wsilverio/te161-conversor-boost/relatorio-final/relatorio-final-boost.pdf

UNIVERSIDADE FEDERAL DO PARANÁ

BRUNA RIBEIRO RESENDE

WENDEURICK SILVERIO

PROJETO DE CONVERSORES CC-CC

CONVERSOR ELEVADOR DE TENSAO (BOOST) ˜

CURITIBA

2018

BRUNA RIBEIRO RESENDE

WENDEURICK SILVERIO

PROJETO DE CONVERSORES CC-CC

CONVERSOR ELEVADOR DE TENSAO (BOOST) ˜

Relatório apresentado à disciplina de Conversores CC-CC e Inversores do curso de Engenharia Elétrica do Departamento de Engenharia Elétrica, Setor de Tecnologia da Universidade Federal do Paraná.

Orientador: Prof. | Dr. | João Américo
Vilela Júnior.

CURITIBA

2018

Conteúdo

1 Introdução | 2
2 Objetivos | 2
3 Especificação de Componentes do Conversor | 2
4 Projeto do Indutor | 10
5 Projeto do Compensador | 12
6 Placa de Circuito Impresso | 20
7 Resultados | 24
8 Conclusões | 32

### 1 Introdução

Por fim, são apresentadas e discutidas as conclusões e observações de cada etapa

do desenvolvimento do projeto proposto.

### 2 Objetivos

### 2.1 Objetivo Geral

A finalidade do projeto apresentado se resume na implementação de uma das

topologias de conversor CC-CC, neste caso, o conversor elevador de tensão (Boost). Esta implementação seguirá as seguintes especificações:

Tabela 1: Especificações do Conversor CC-CC Boost

Parâmetros de Implementação
Tensão de Entrada | 9 − 18Vcc
Tensão de Saída | 24Vcc
Frequência de Comutação | 250kHz
Potência do Conversor | 30W

### 2.2 Objetivos Específicos

- Especificação dos componentes do conversor;
- Projeto do indutor;
- Definição e simulação do compensador;
- Layout e confecção da placa de circuito impresso;
- Testes em bancada para verificação do funcionamento do conversor Boost

de acordo com as especificações do projeto.

### 3 Especificação de Componentes do Conversor

Nesta seção é realizado o levantamento dos dados necessários para a determinação dos componentes de um conversor CC-CC elevador (Boost) (Figura

1), cuja a especificação é dada a seguir: Vin = 9 − 18V , Vout = 24V , P = 30W

e F req = 250kHz.

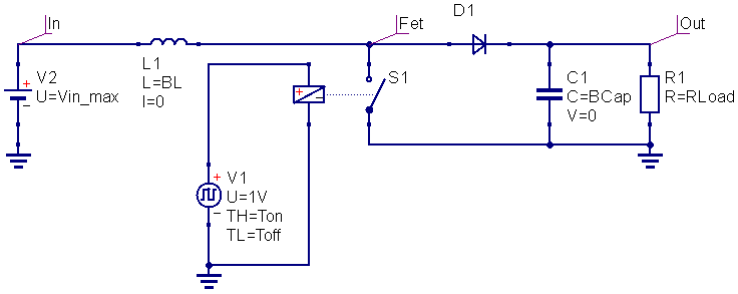
[picture p38: figure]

Figura 1: Esquemático do conversor Boost.

A partir desses parâmetros, tem-se os valores da carga e sua corrente média:

Rout =

V

2
out
P

=

24²

30

= 19, 2Ω

(1)

Ioutmed =

P

Vout

=

30
24

= 1, 250A

(2)

Com isso, através do software Qucs, simulou-se o circuito da Figura 1, obtendo-

se os parâmetros a seguir.

1. Capacitor
(a) Capacitância

A escolha da capacitância leva em conta a variação da tensão de saída

(4Vout ) e a razão cíclica (D) da chave.

O ciclo de trabalho foi calculado para o pior caso, ou seja, quando D assume seu valor máximo (quando a tensão de entrada assume o valor

mínimo):

D = 1 −

Vin

Vout

= 1 −

9
= 62.5%

(3)

Para este projeto, adotou-se a variação de tensão igual a 4%. A Equação

4 apresenta o cálculo do valor mínimo da capacitância.

Cap ≥

Dmax · Iout

4Vout · freq

=

62, 5% · 1, 250
4% · 250k

= 78, 125µF

(4)

(b) Tensão máxima

Através da simulação, obteve-se a tensão máxima que o capacitor deve

suportar (37,5V, quando Vin = 18V ).

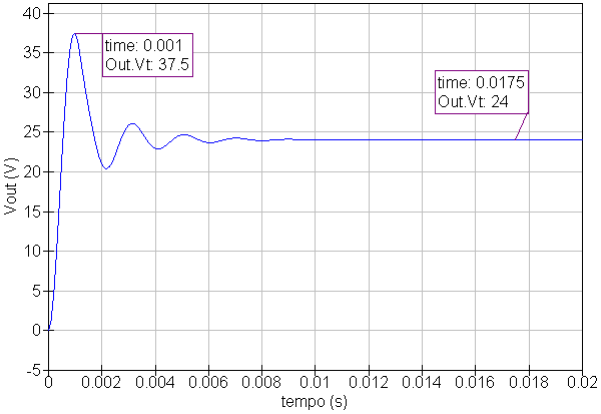
[picture p39: figure]

Figura 2: Pico de tensão sobre a carga/capacitor.

(c) ESR máxima

Neste projeto, adotou-se 4% como sendo o valor da máxima variação da

corrente de saída (4Iout ). A Equação 5 apresenta o cálculo da resistência

séria máxima do capacitor.

ESR ≤

4Vout

4Iout

=

4%
4% = 1Ω

(5)

2. Indutor
(a) Indutância

O cálculo para o valor mínimo da indutância (Equação 7) foi feito sobre

o ponto onde o produto (D · Vin) atinge seu valor máximo:

max {D · Vin} = max
(Vout − Vin)

Vout

- Vin

= max
(24 − Vin)
24
- Vin
= 6 → Vin = 12 → D = 50%

(6)

L ≥

D · Vin
4IL
- freq

=

6
4% · 250k

= 600µH

(7)

(b) Corrente média

Através da simulação, obteve-se a corrente média que o indutor deve

suportar (4,51A, quando Vin = 9V ).


Figura 3: Corrente média sobre o indutor.

(c) Corrente máxima

Através da simulação, obteve-se a corrente máxima que o indutor deve

suportar (8,22A, quando Vin = 18V ).


Figura 4: Corrente máxima sobre o indutor.

3. Diodo
(a) Corrente média e corrente máxima

A corrente no diodo é aproximadamente igual à corrente sobre a carga

(desconsiderando os picos de carga sobre o capacitor).


Figura 5: Corrente sobre o diodo/carga.

Através da simulação, obteve-se a corrente média e máxima que o diodo deve suportar (1,25A e 1,95, respectivamente, quando Vin = 18V ).

(b) Tensão reversa máxima

Através da simulação, obteve-se a máxima tensão reversa que o diodo

deve suportar (35,6V, quando Vin = 18V ).


Figura 6: Tensão reversa sobre o diodo.

4. Mosfet
(a) Corrente média

Através da simulação, obteve-se a corrente média que a chave deve

suportar (4,54A, quando Vin = 9V ).


Figura 7: Corrente média sobre a chave.

(b) Corrente máxima

Através da simulação, obteve-se a corrente máxima que a chave deve

suportar (8,22A, quando Vin = 18V ).


Figura 8: Corrente máxima sobre a chave.

(c) Tensão Dreno-Fonte

Através da simulação, obteve-se a tensão máxima que a chave deve

suportar (8,22V, quando Vin = 18V ).


Figura 9: Tensão máxima sobre a chave.

Escolha dos componentes

A partir dos dados obtidos através dos cálculos, da simulação e da disponibili-

dade, foram definidos os seguintes componentes:

1. Capacitor
- Fabricante: Nichicon
- Part number: UVR1H470MED1TD
- Capacitância: 2x47µF ±20% (2 em paralelo)
- Tensão máxima de operação: 50V
- ESR: não especificada pelo fabricante. Medida: 490mΩ.
2. Diodo
- Fabricante: Vishay General Semiconductor
- Part number: SB260
- Queda de tensão: 680mV @ 2A
- Corrente média: 2,0A
- Pico máximo de corrente: 60A @ 8,3ms
- Máxima tensão reversa: 60V
3. Mosfet
- Fabricante: Infineon Technologies
- Part number: IRFZ44EPBF
- Corrente média: 48A
- Pico máximo de corrente: 192A
- Tensão máxima entre dreno e fonte: 60V
- Resistência Dreno-Fonte modo triodo: 23mΩ @VGS = 10V, ID = 29A
- Tensão de limiar no gate: 2V - 4V

### 4 Projeto do Indutor

Para o cálculo do número de espiras do indutor em questão, foi utilizada a me-

todologia a partir do comprimento de entreferro. Assim, o carretel foi projetado

de forma que o comprimento do entreferro fosse igual a 1,6mm, ou seja:

lg
2

= 0, 8mm

N =

s
lg · L
µ0 · Ae

=

s
1, 6 · 10⁻³
- 600 · 10⁻⁶
4 · π · 10⁻⁷
- 1, 7 · 10⁻⁴

= 67, 09 espiras

Onde:

- L - indutância [H]
- µ0 - permeabilidade magnética do vácuo [H/m]
- Ae - área do núcleo [m²
]

Assim, utilizou-se 68 espiras para a construção do indutor. No entanto, é ne-

cessário verificar se a densidade de fluxo Bmax não ultrapassa o valor de 0,3T,

provocando a saturação do núcleo. Como pode ser observado na Equação 8,

não haverá saturação.

Bmax =

L · Ipico
N · Ae

=

600 · 10⁻⁶
- 1, 275
68 · 1, 7 · 10⁻⁴
= 0, 066T | (8)

Foi então analisada a área disponível para o número de espiras calculado, pela

equação abaixo, considerando a densidade de corrente máxima Jmax igual a 450A/cm²
e a corrente eficaz Ief igual a 1,25 A.

At =

Ief

Jmax

= 0, 0027cm² = 0, 27mm²
(9)

No entanto, a corrente utilizada foi equivocada, uma vez que se considerou a

corrente de saída média e não a corrente máxima que efetivamente passa pelo

indutor em regime permanente. O erro foi identificado após a implementação do

conversor e durante os ensaios, onde o indutor aqueceu. Refazendo os cálculos

para verificar a dimensão do erro, utilizou-se a corrente máxima, na condição

da tensão de entrada mínima, igual a 3,33 A:

At =

Imax

Jmax

= 0, 0074cm² = 0, 74mm²
(10)

Dessa forma, seria necessária a utilização de um condutor AW G18, cuja seção é de 0, 82mm²

Porém, como se está operando em frequência elevada para eletrônica de potência,

deve-se considerar o efeito pelicular, utilizando a frequência do projeto igual a

250kHz.

4 =

7, 5
√
f

= 0, 015cm = 0, 15mm

Como o raio do condutor deve ser menor que 4, o condutor mais indicado

seria o AW G29, cujo raio é de 0,14295mm. No entanto, havia a disponibilidade

do condutor AW G30 e assim, seria necessária a utilização de um número de

condutores em paralelo obtido pela equação:

ncp =

AW G18
AW G30

= 16, 07 ≈ 17 condutores em paralelo

Assim, realizando os mesmos cálculos, porém com o valor da corrente média de

saída, foi obtido um número de 3 condutores em paralelo utilizando o AW G30,

valor muito distante do necessário. Assim, o indutor foi construído com o

condutor AW G30 e 3 condutores em paralelo.

Após a construção do indutor, a medição de sua indutância indicou aproxima-

damente 643, 7µH. Além disso, a ESR medida foi igual a 480mΩ. (obs.: a

Seção 8 aborda novamente o projeto do indutor).

### 5 Projeto do Compensador

### 5.1 Circuito de Controle

O compensador escolhido foi o do Tipo 3, cujo circuito e função transferência

são apresentados nas Figuras 10 e 11, respectivamente.


Figura 10: Circuito do Compensador Tipo 3.

Figura 11: Função transferência do Compensador Tipo 3.

A equação 11 apresenta a função transferência do conversor Boost.

GBoost =

Vin
L · C · (1 − D)

2

·

−

RSE·L·C·s

2
R0

+

RSE · C −

L
R0

- s + 1
s

2 +

1
R0·C +

RSE
L
- s +

1
L·C
| (11)

Onde

- Vin: tensão de entrada
- L: valor do Indutor Boost
- C: valor do Capacitor Boost
- RSE: ESR do capacitor
- R0: carga do circuito
- D: razão cíclica
- s: variável no plano complexo (frequência complexa)

O projeto do compensador foi dado no ponto V in = 13, 5V . Assumindo esse

valor na Equação 3, tem-se o valor da razão cíclica igual a D = 0, 4375.

A fim de se obter valores mais próximos para o caso real, os componentes físicos

foram medidos e o compensador foi projetado levando em conta esses valores.

- L = 643, 7µH
- C = 2 · 47µ = 94µF (capacitores em paralelo)
- RSE = 0, 49Ω/2 = 0, 245Ω (capacitores em paralelo)
- R0 = 19, 2Ω

Com isso, obteve-se os diagramas de Bode em malha aberta, apresentados na

Figura 12. Logo após, escolheu-se 2,08kHz para ser a frequência de corte em malha fechada, ponto onde a fase é de 166o

(-194o
) e magnitude é de 14dB

(5,01V/V).


Figura 12: Diagramas de Bode da função transferência do conversor Boost.

Optou-se pela margem de fase igual a 60o . Com isso, obteve-se o avanço de

fase, conforme a Equação 12.

φavanço = −90◦ + MFdesejada − ⁶ GBoost |fc

= −90◦ + 60◦ − (−194◦

) = 164◦

(12)

O ganho do compensador deve ser tal que leve a um ganho unitário em malha fechada, na frequência de corte (Equação 13).

| GF TMA (s) |fc=| GC (s) |fc

- | GPWM (s) |fc
- | GBoost (s) |fc

·k = 1 (13)

Substituindo os seguintes valores na Equação 13, obteve-se o Ganho do Compensador | Gc (s) |fc= 1, 7957V/V .

- Ganho da planta do conversor: | GBoost (s) |fc= 5, 01
- Ganho da modulação PWM: | GPWM (s) |fc= 1/Vtriang = 1/1, 8 = 0, 5556
- Ganho do divisor resistivo de feedback: k = 5V/24V = 0, 2

O fator kpz é dado pela Equação 14.

kpz =

tan
φavanço
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
= 204, 5091

(14)

Tomando o resistor R1 = 510kΩ, calculou-se os demais componentes do com-

pensador.

C2 =

1
2 · π · fc
- R1· | Gc (s) |

=

1
2 · π · 2, 08kHz · 510kΩ · 1, 7957

= 83, 550pF

(15)

C1 = C2 · (kpz − 1)

= 83, 550pF · (204, 5091 − 1) = 17nF

(16)

R2 =

p
kpz
2 · π · fc · C1

=

√
204, 5091
2 · π · 2, 08kΩ · 17nF

= 64, 355kΩ

(17)

R3 =

R1
kpz − 1

=

510kΩ
204, 5091 − 1

= 2, 51kΩ

(18)

C3 =

1
2 · π · fc
- R3 ·

p
kpz

=

1
2 · π · 2, 08kHz · 2, 51kΩ ·

√
204, 5091

= 2, 14nF

(19)

Após os cálculos, foi feita uma aproximação com valores comerciais e/ou dis-

poníveis, através de arranjos série/paralelo, obtendo aos seguintes valores:

Tabela 2: aproximação com valores comerciais/disponíveis

R1 (kΩ) | 510
R2 (kΩ) | 56
R3 (kΩ) | 2,2
C1 (nF) | 17,2
C2 (pF) | 94
C3 (nF) | 2,2

Substituindo as devidas funções transferências no sistema da Figura 13, obteve-

se os diagramas de Bode da Figura 14.

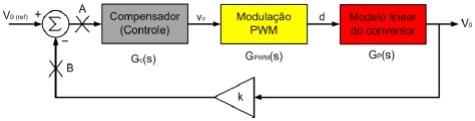
[picture p40: figure]

Figura 13: Sistema de controle do conversor Boost.

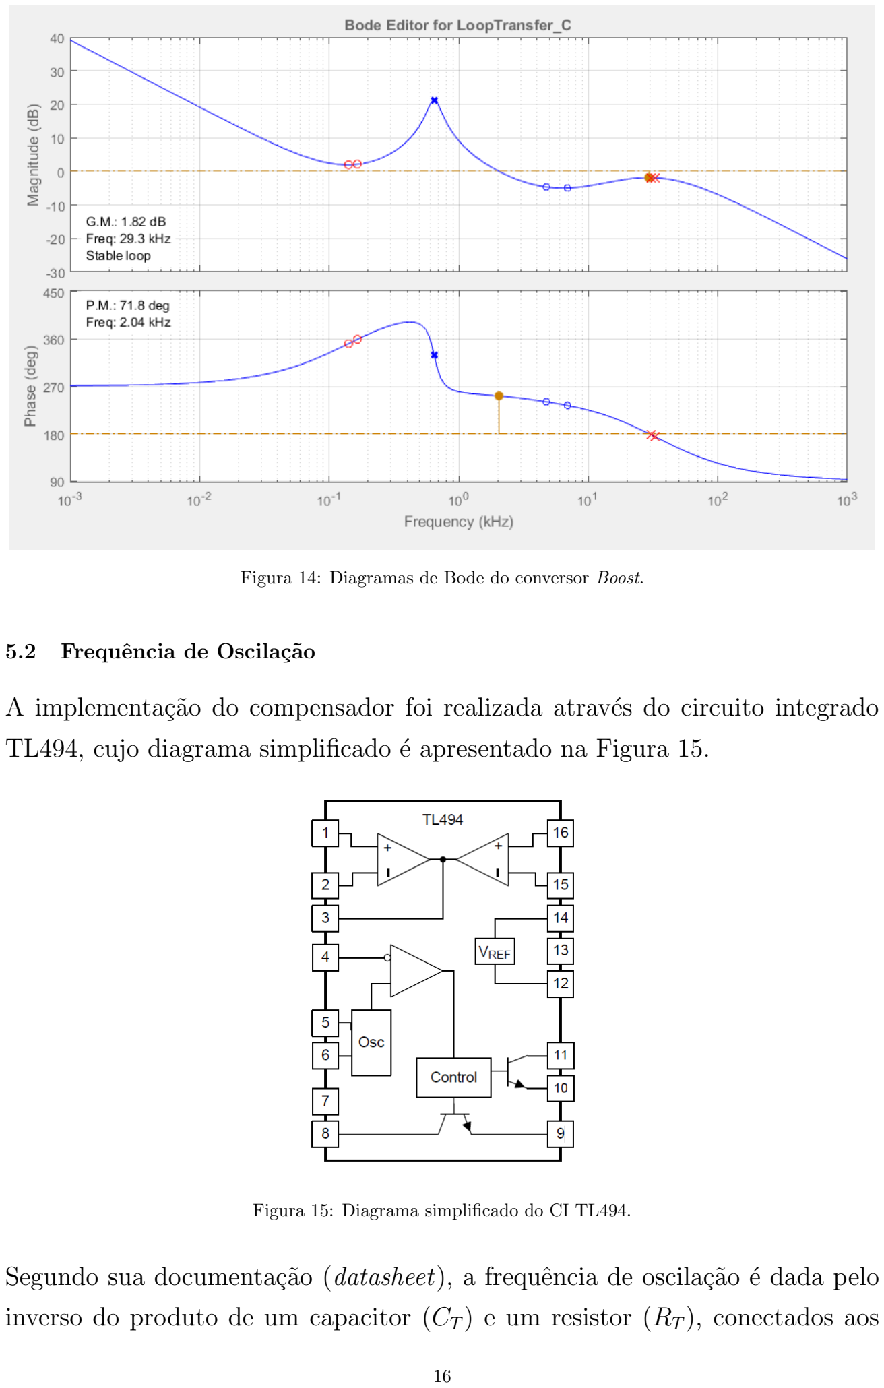
[picture p41: page 18]

Figura 14: Diagramas de Bode do conversor Boost.

### 5.2 Frequência de Oscilação

A implementação do compensador foi realizada através do circuito integrado

TL494, cujo diagrama simplificado é apresentado na Figura 15.

Figura 15: Diagrama simplificado do CI TL494.

Segundo sua documentação (datasheet), a frequência de oscilação é dada pelo

inverso do produto de um capacitor (CT ) e um resistor (RT ), conectados aos pinos 5 e 6, respectivamente. O cálculo para fOSC ≈ 250kHz é apresentado na

Equação 20.

fOSC =

1

CT · RT

=

1
1, 8nF · 2, 2kΩ

= 253kHz

(20)

### 5.3 Tensão de feedback

A entrada não-inversora do comparador (pino 1) recebe a tensão de feedback do

conversor Boost, devendo ser ajustada à faixa 0V - 5V. Para isso, implementou-

se um divisor resistivo, apresentado na Equação 21.

Vfeedbackmax =

24V · 1kΩ
1kΩ + 3, 8kΩ
= 5V | (21)

### 5.4 Soft-start e tempo-morto

As técnicas de soft-start e tempo-morto são necessárias para mitigar o estresse

sobre o Mosfet durante a inicialização do sistema, fazendo com que o capacitor

Boost se carregue lentamente. A Figura 16 apresenta a limitação do ciclo de

trabalho em função da tensão aplicada no pino 4 do circuito integrado.

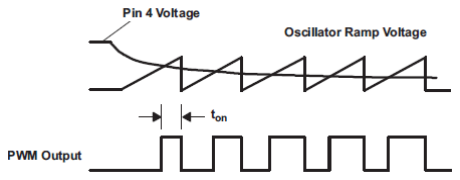
[picture p42: figure]

Figura 16: Controle do ciclo de trabalho.

A entrada do comparador do tempo-morto (pino 4) trabalha com tensões entre

0V e 3,3V, fazendo com que o Mosfet seja cortado, proporcionalmente, de 3%

a 100%, ou seja, a razão cíclica varia entre 0,97 e 0.

A Equação 22 apresenta o cálculo para a máxima tensão no pino 4 em função

do máximo valor da razão cíclica (escolhido D = 85%).

V4max =

3, 3V · (0, 97 − 0, 85)
0, 97
= 0, 408V | (22)

Como pode ser notado na Figura 17, a tensão interna de referência é de 5V,

sendo necessário um divisor resistivo para limitar o pino 4 em 0,408V. Assu-

mindo o resistor shunt igual a 10kΩ, tem-se o seguinte valor do resistor RTss (Equação 23).


Figura 17: Circuito de soft-start.

RTss = Rshunt ·

Vref

V4max

− 1

= 10kΩ ·

5V
0, 408V

− 1

≈ 110kΩ

(23)

Para o tempo de soft-start, definiu-se o equivalente para 93 ciclos de clock,

assim, o valor da capacitância é dada pela Equação 24.

Css =

1

fOSC

·

Nciclos

RTss

=

1
250kHz ·

93
110kΩ

≈ 3, 3nF

(24)

A Figura 18 apresenta o circuito de controle/compensação completo.


Figura 18: Circuito de controle/compensação.

### 6 Placa de Circuito Impresso

A placa de circuito impresso foi projetada com base em boas práticas de leiaute

e alguns cuidados foram tomados em relação à disposição dos circuitos.

O circuito de potência (Figura 19) foi projetado com trilhas largas e buscou-

se fazê-lo com o menor loop possível. Ademais, para diminuir os efeitos da

ESR, o capacitor Boost de 78, 125µF foi substituído por 2 capacitores (CB1

e CB2) de 47µF em paralelo, totalizando ≈ 100µF e metade da ESR inicial

(490mΩ/2 = 245mΩ).

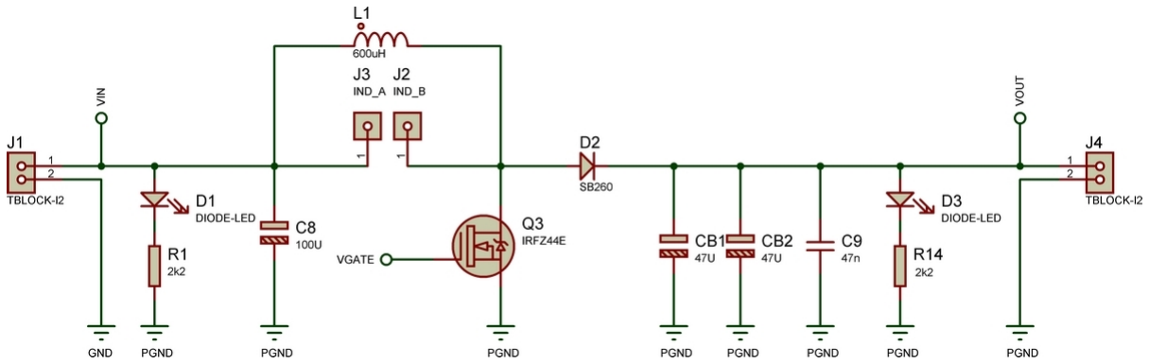
[picture p43: figure]

Figura 19: Esquemático do circuito de potência.

Para evitar que ruídos provenientes dos circuitos de potência (Figura 19) e

de chaveamento (Figura 20) interferissem no circuito de controle (Figura 18),

separou-se os terras através de componentes virtuais neckties, como apresentado

na Figura 21. Dessa forma, cada circuito é tratado de forma individual, tendo a ligação das referências próxima ao conector de entrada (Figura 22).


Figura 20: Esquemático do circuito de chaveamento.


Figura 21: Separação dos terras de alta (PGND) e baixa (AGND) potência.

Além disso, o circuito de controle foi confinado em um pequeno plano de terra

individual, como apresentado na Figura 22.


Figura 22: Destaque do plano confinado e neckties na entrada do circuito separando os terras.

Com o circuito de controle estando afastado do conector de entrada, foram

colocados 2 capacitores de desacoplamento próximos ao CI TL494.

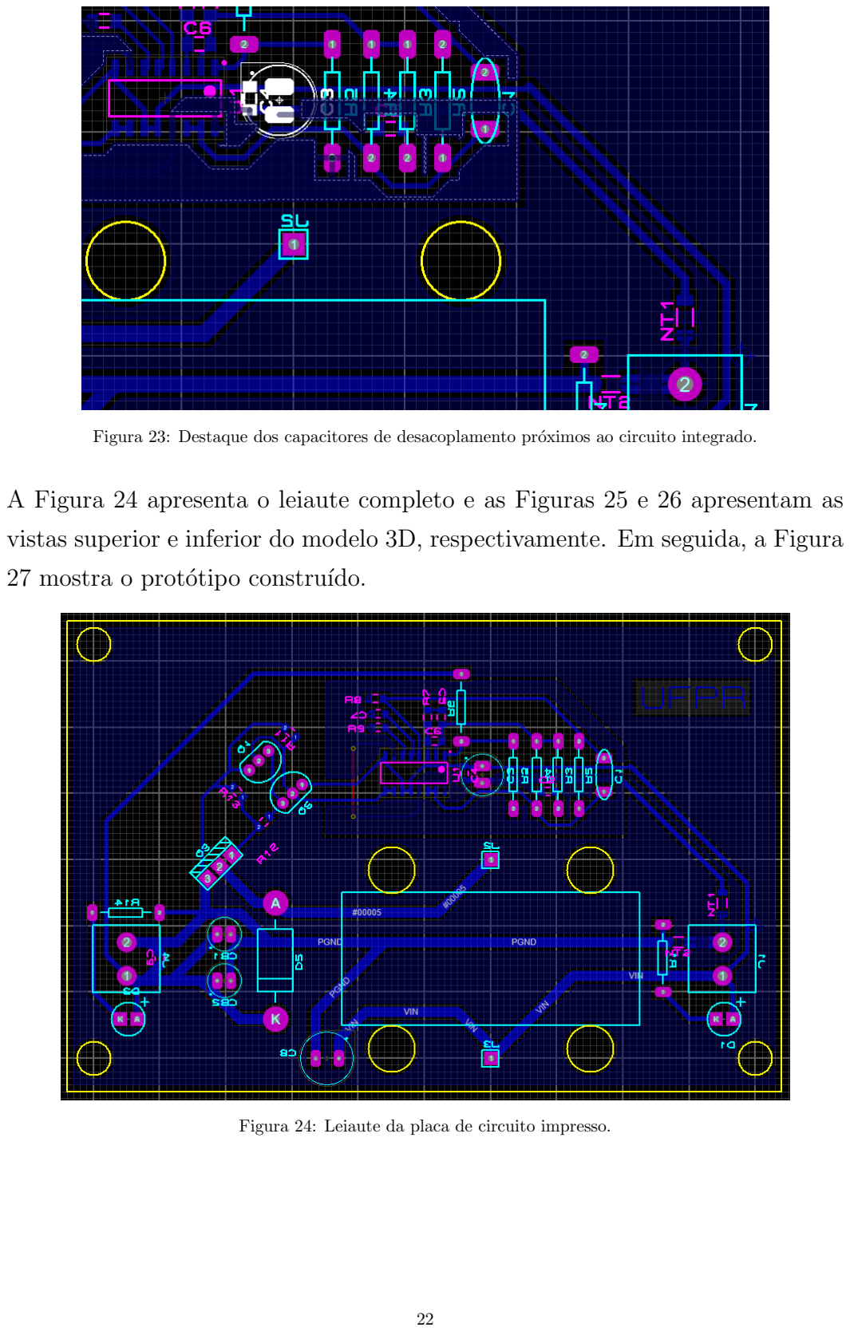
[picture p44: page 24]

Figura 23: Destaque dos capacitores de desacoplamento próximos ao circuito integrado.

A Figura 24 apresenta o leiaute completo e as Figuras 25 e 26 apresentam as

vistas superior e inferior do modelo 3D, respectivamente. Em seguida, a Figura

27 mostra o protótipo construído.

Figura 24: Leiaute da placa de circuito impresso.

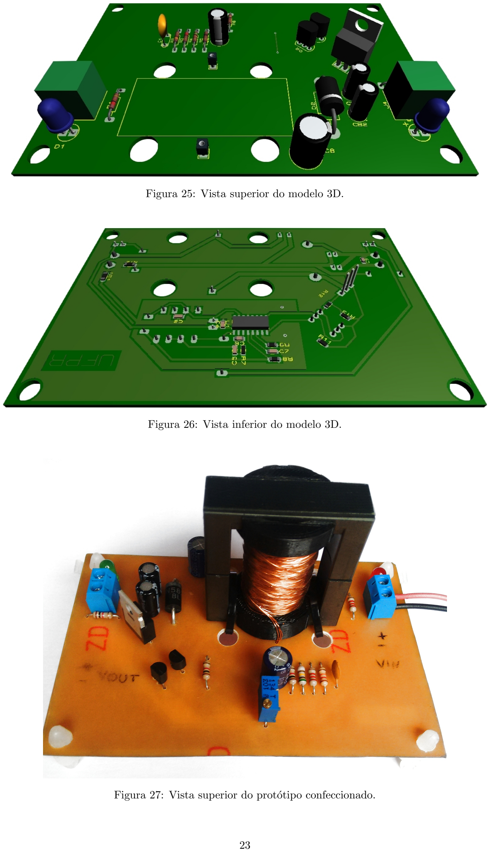
[picture p45: page 25]

Figura 25: Vista superior do modelo 3D.

Figura 26: Vista inferior do modelo 3D.

Figura 27: Vista superior do protótipo confeccionado.

### 7 Resultados

Os parâmetros analisados foram obtidos em 3 pontos bem definidos sobre a

faixa de operação: 9V, 13,5V e 18V.

### 7.1 Ondulação da tensão de saída

As Figuras 28, 29 e 30 apresentam o ripple (ondulação) da tensão de saída para

os 3 casos citados, com carga de 30W.


Figura 28: Ripple da tensão de saída @Vin=18V.

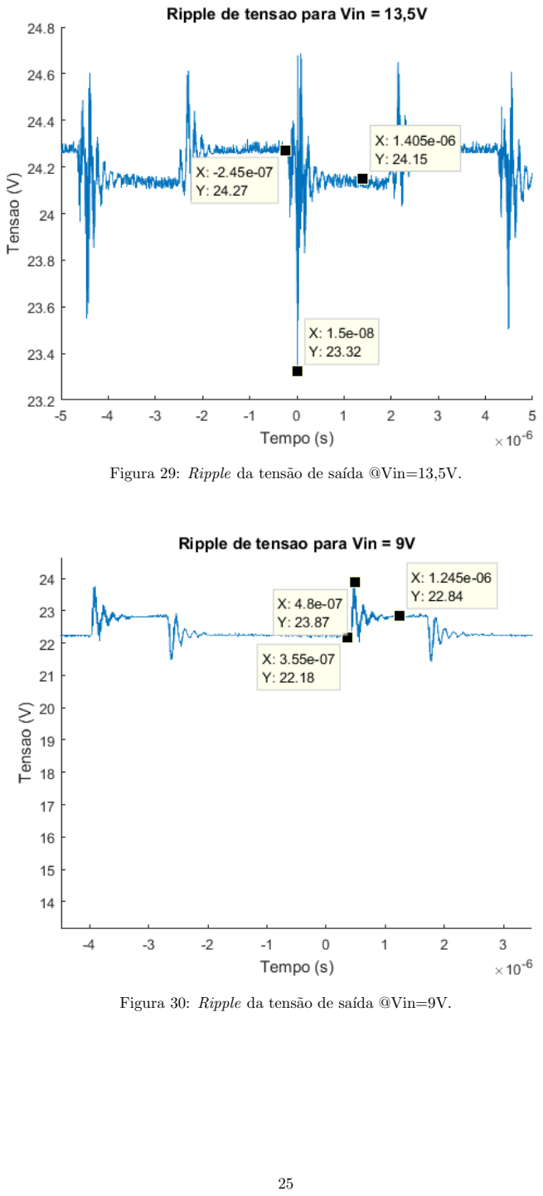
[picture p46: page 27]

Figura 29: Ripple da tensão de saída @Vin=13,5V.

Figura 30: Ripple da tensão de saída @Vin=9V.

### 7.2 Transitório para o aumento da carga

Para esta análise, alterou-se a carga de 15W (2 · RCarga = 38, 4Ω) para 30W

(RCarga = 19, 2Ω). As Figuras 31, 32 e 33 apresentam a oscilação da tensão de

saída em função da alteração brusca (degrau) da carga.


Figura 31: Oscilação da tensão de saída devido a alteração brusca da carga @Vin=18V.

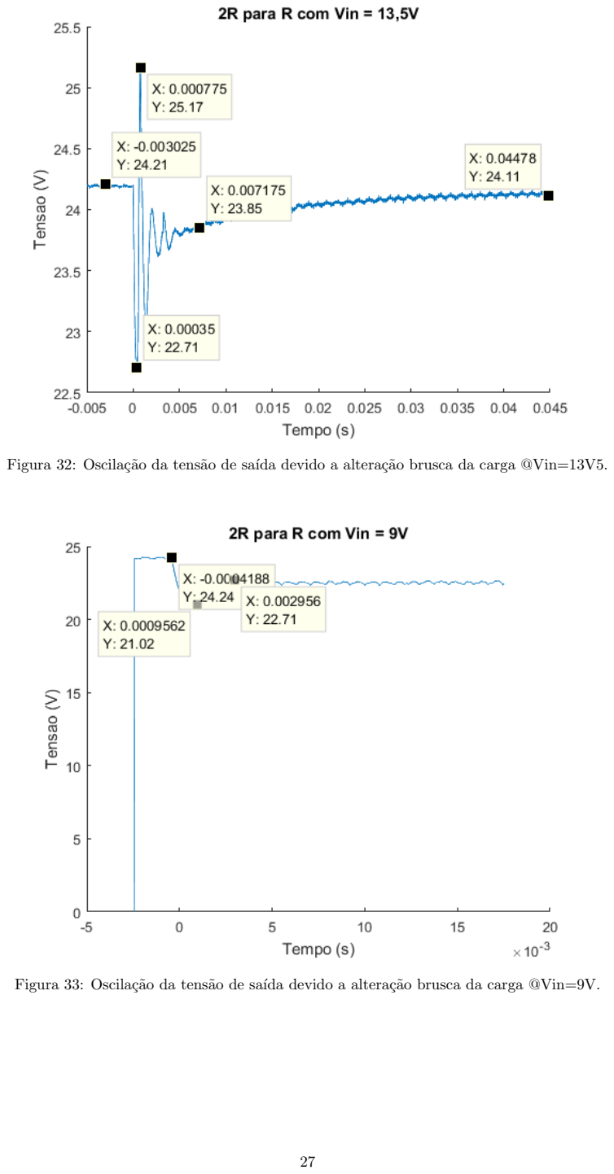
[picture p47: page 29]

Figura 32: Oscilação da tensão de saída devido a alteração brusca da carga @Vin=13V5.

Figura 33: Oscilação da tensão de saída devido a alteração brusca da carga @Vin=9V.

### 7.3 Transitório para a diminuição da carga

Similar ao caso anterior, alterou-se a carga de 30W (RCarga = 19, 2Ω) para 15W

(2 · RCarga = 38, 4Ω). As Figuras 34, 35 e 36 apresentam a oscilação da tensão

de saída em função da alteração brusca (degrau) da carga.


Figura 34: Oscilação da tensão de saída devido a alteração brusca da carga @Vin=18V.

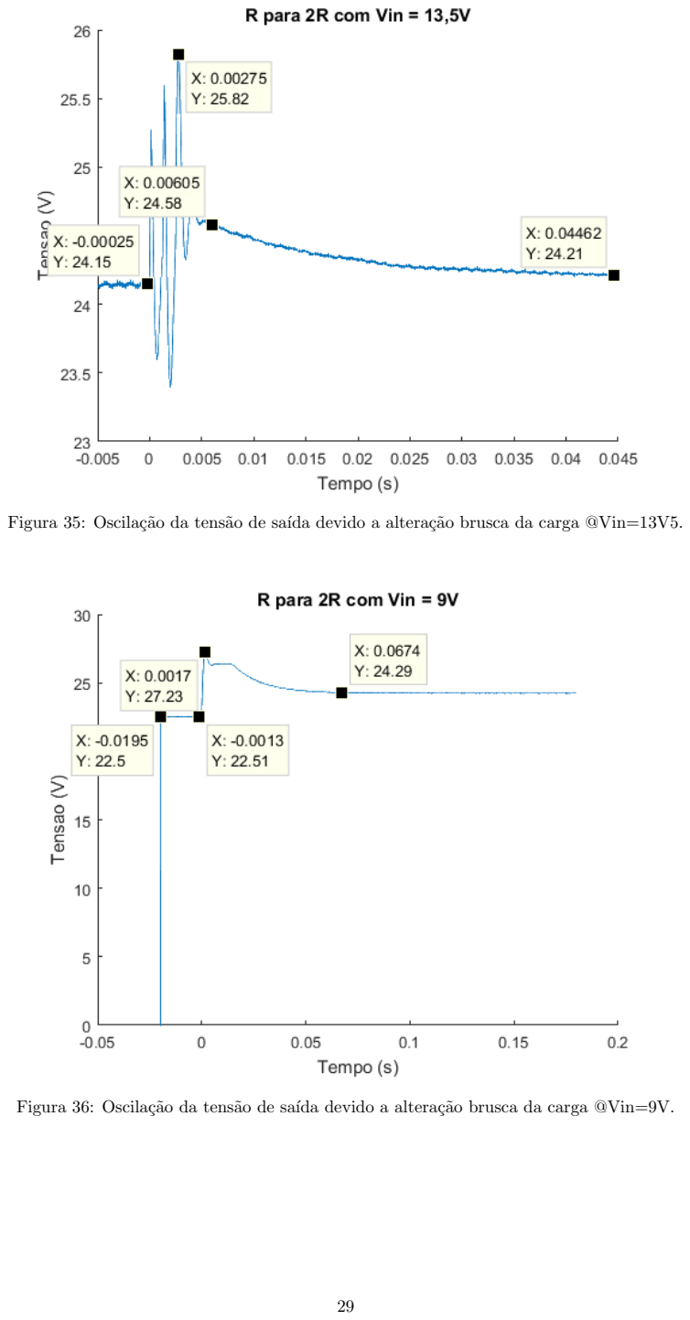
[picture p48: page 31]

Figura 35: Oscilação da tensão de saída devido a alteração brusca da carga @Vin=13V5.

Figura 36: Oscilação da tensão de saída devido a alteração brusca da carga @Vin=9V.

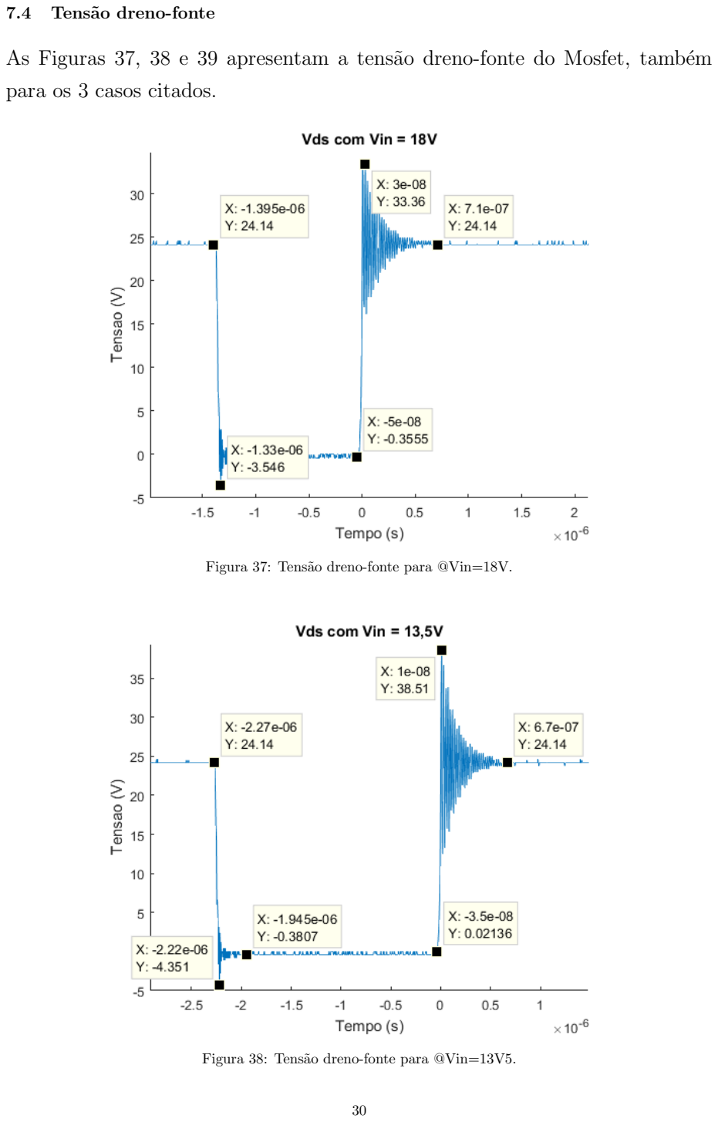
[picture p49: page 32]

### 7.4 Tensão dreno-fonte

As Figuras 37, 38 e 39 apresentam a tensão dreno-fonte do Mosfet, também

para os 3 casos citados.

Figura 37: Tensão dreno-fonte para @Vin=18V.

Figura 38: Tensão dreno-fonte para @Vin=13V5.


Figura 39: Tensão dreno-fonte para @Vin=9V.

### 8 Conclusões

Como se pôde notar na Seção 7, o conversor Boost não atendeu todas as especi-

ficações de projeto. Um indicativo de que havia algo errado foi o fato do indu-

tor estar aquecendo consideravelmente. Ao percebê-lo, reviram-se os cálculos e

notou-se que as correntes eficaz e de pico levadas em conta nas Equações 8 e

10 estão mal levantadas. O correto seria ter considerado os valores de pico da simulação (Seções 2b e 2c). Com o indutor aquecendo, o material do carretel,

produzido em impressora 3D, começou a amolecer. Isso causou a diminuição do entreferro (devido ao peso do núcleo estar sobre o carretel), levando à sa-

turação. Com o núcleo saturado, o indutor não conseguia fornecer a corrente

necessária para suprir a demanda. Com isso, percebe-se que, nos casos em que há maior demanda de corrente (por exemplo, Figura 30), a tensão de saída fica

muito abaixo dos 24V esperados.

Observou-se também que a simulação apresentou valores não condizentes com o

caso real. Como pode-se notar na Seção 7.4, os valores das tensões entre dreno

e fonte foram maiores que os apresentados na Seção 4c. Por sorte, os valores

reais estavam dentro do limite suportado pelo Mosfet.
