wsilverio/te161-conversor-boost/relatorio-final/ESR.png

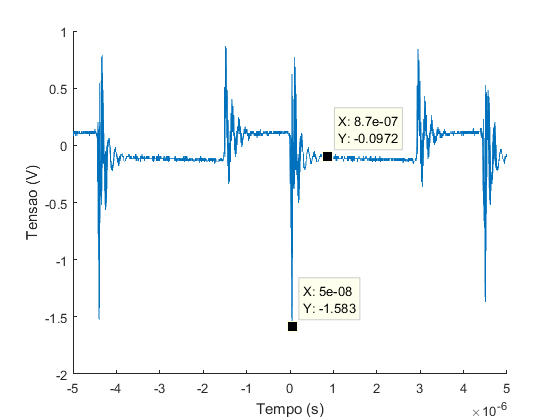
relatorio-final/ESR.png
