wsilverio/te161-conversor-boost/relatorio-final/icarga_vinmin.png

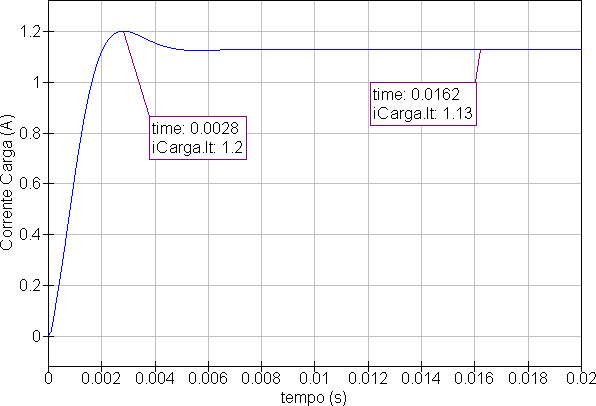
relatorio-final/icarga_vinmin.png
