wsilverio/te161-conversor-boost/relatorio-final/top.png

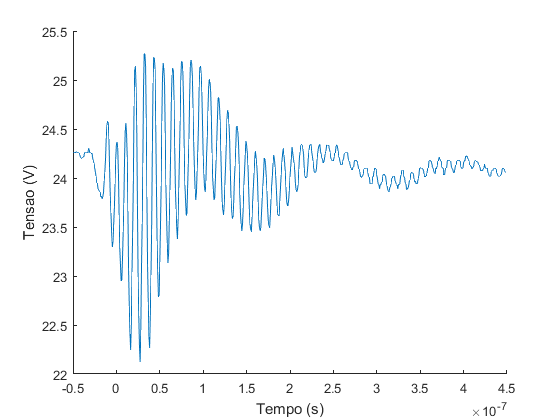
relatorio-final/top.png
