wsilverio/te161-conversor-boost/relatorio-final/vdrev_vinmin.png

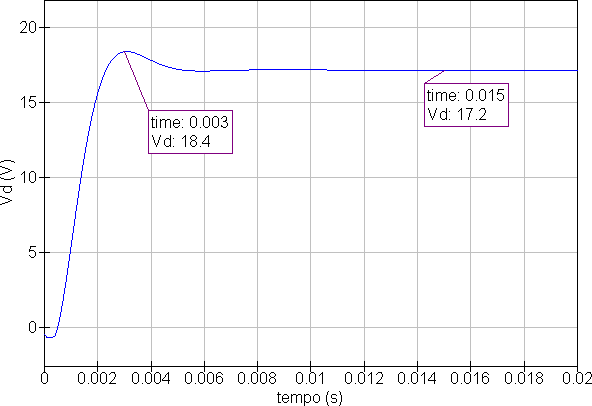
relatorio-final/vdrev_vinmin.png
