wsilverio/te161-conversor-boost/relatorio-final/vout_vinmin.png

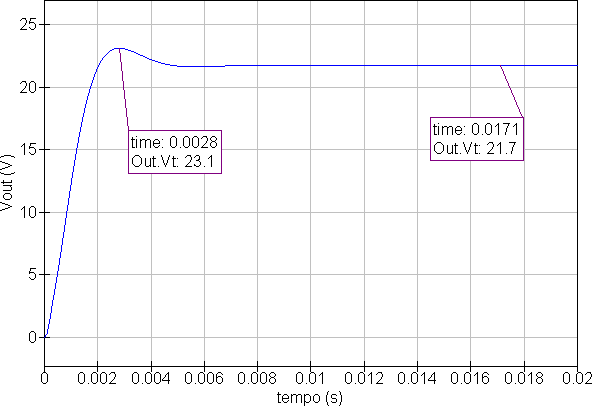
relatorio-final/vout_vinmin.png
