wsilverio/te161-conversor-boost/pcb/conversor-boost.PDF

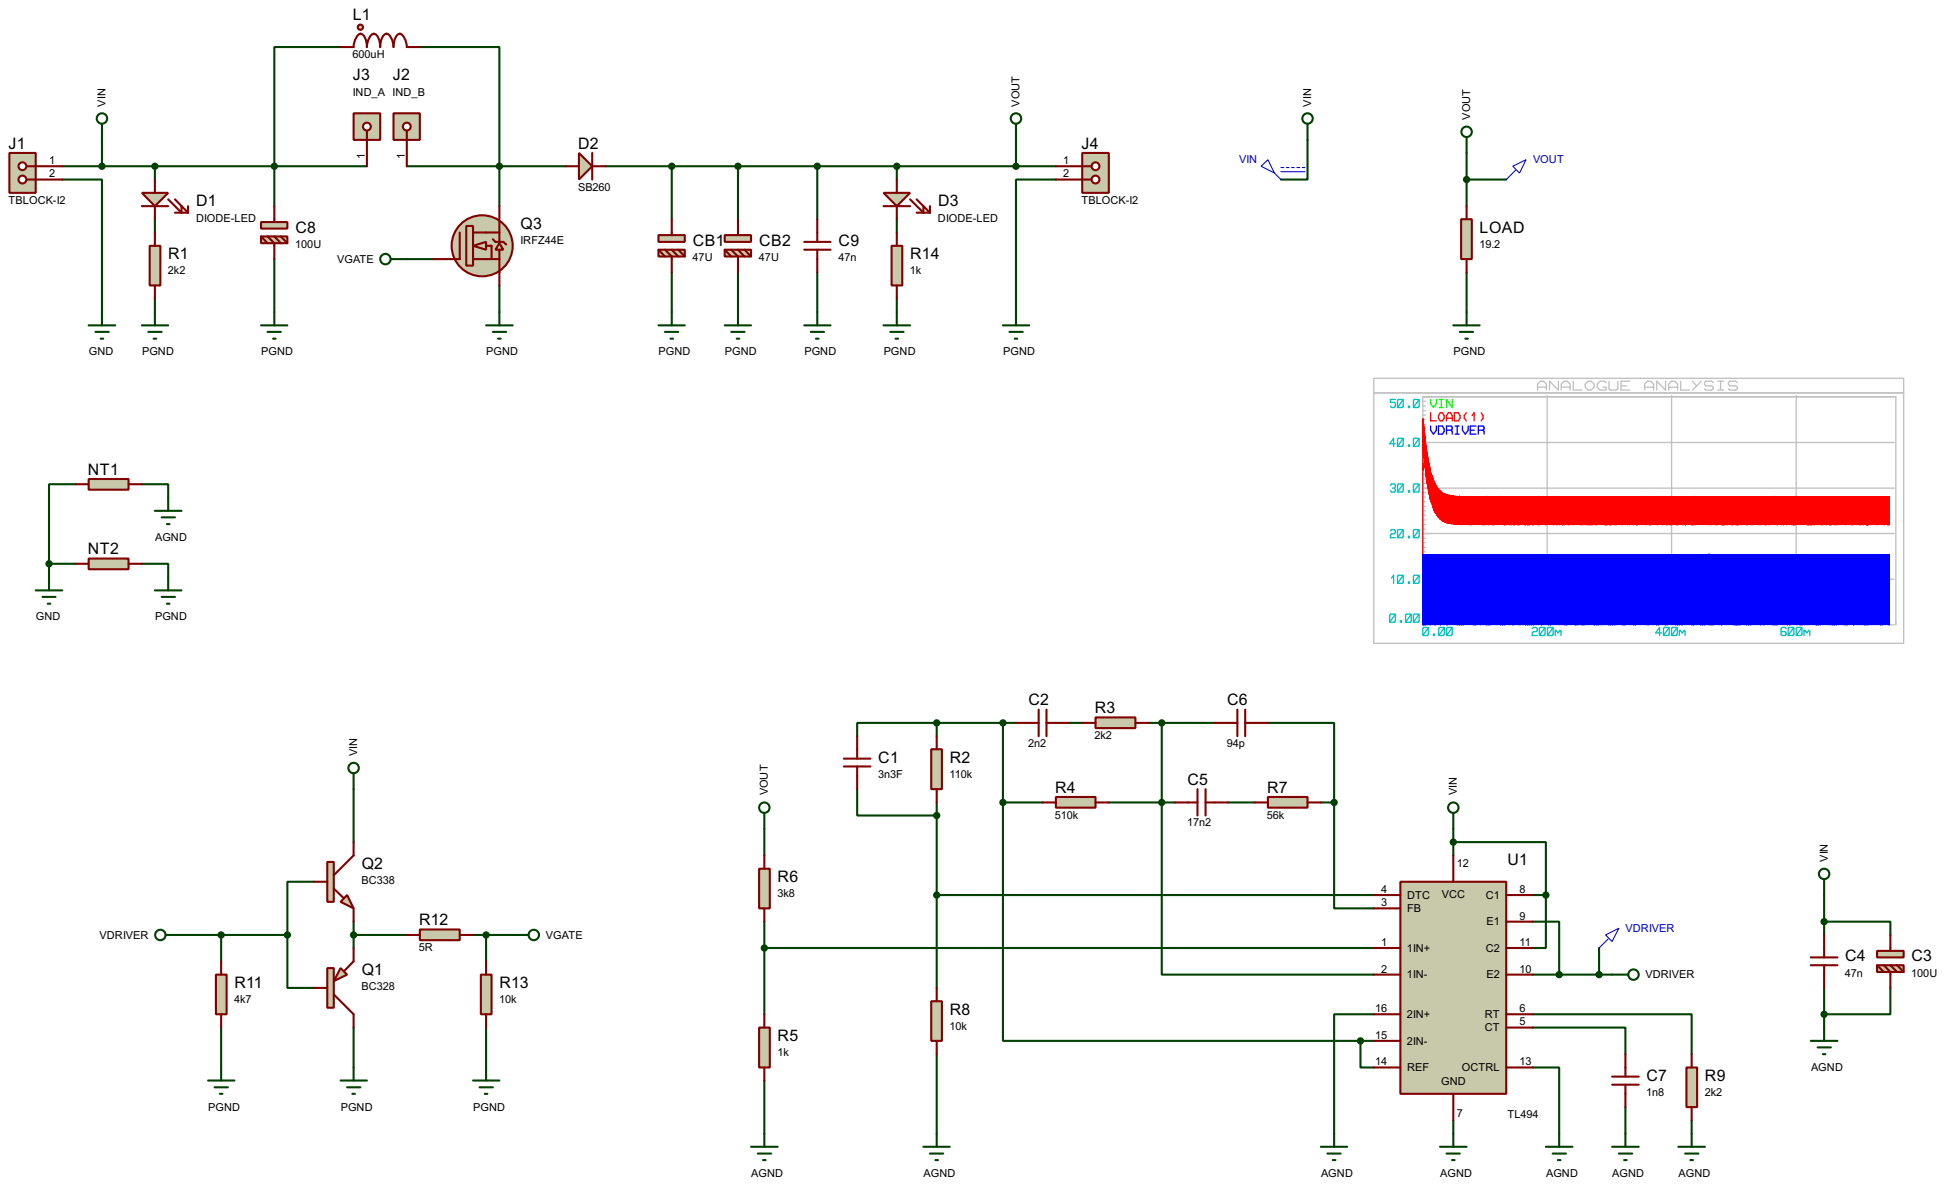
[picture p56: page 1]
