wsilverio/te161-conversor-boost/pcb/conversor-boost-filme.pdf

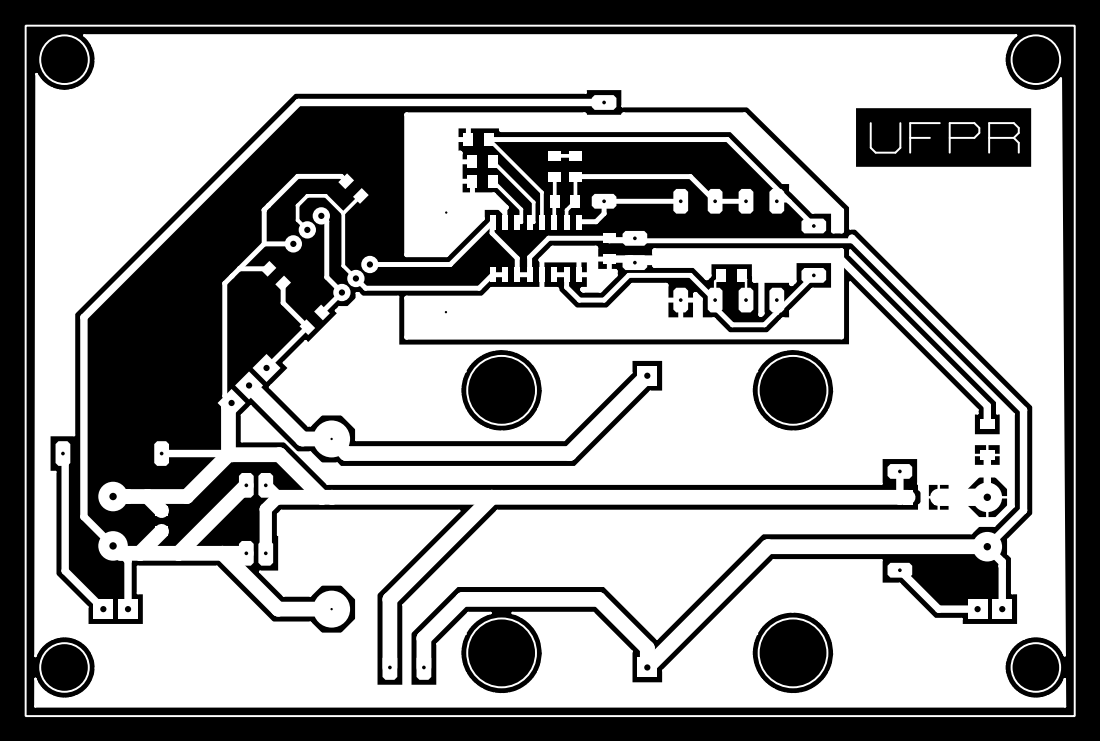
[picture p57: page 1]
