wsilverio/te161-conversor-boost/pcb/conversor-boost-papel.pdf

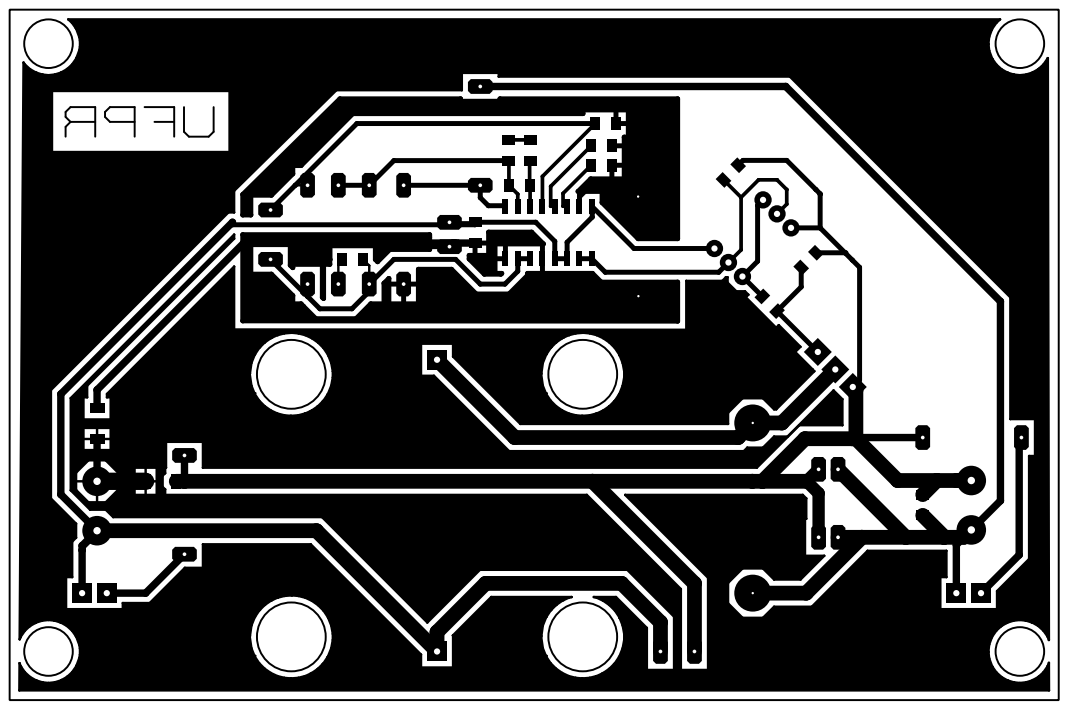
[picture p58: page 1]
