wsilverio/te161-conversor-boost/(list of files, drawings)

Other design files:
conversor-boost.pdsprj
