wsilverio/te161-conversor-boost/(commit log)

2018-04-03 mosfet bruna
2018-04-03 esquematico ok
    [conversor-boost.pdsprj]
2018-04-04 .log (gerber)
2018-04-04 Correções Professor
    [conversor-boost.pdsprj]
2018-04-04 Produção Rev 1
    [conversor-boost - CADCAM Bottom Assembly.GBR, conversor-boost - CADCAM Bottom Copper.GBR, conversor-boost - CADCAM Bottom SMT Paste.GBR, conversor-boost - CADCAM Bottom Silk Screen.GBR, conversor-boost - CADCAM Bottom Solder Resist.GBR, conversor-boost - CADCAM Drill TOP-BOT Plated.GBR, conversor-boost - CADCAM Mechanical 1.GBR, conversor-boost - CADCAM Top Assembly.GBR]
2018-04-10 só queria ir embora
    [conversor-boost.pdsprj]
2018-04-12 placa montada - :ok_hand:
    [conversor-boost.pdsprj]
2018-04-13 Correção do circuito de acionamento
2018-04-19 Medições Lab
    [Arquivos Osciloscópio.ods, scope_0.csv, scope_1.csv, scope_10.csv, scope_11.csv, scope_12.csv, scope_13.csv, scope_14.csv]
2018-05-03 ".fig" osciloscopio
    [Arquivos Osciloscópio.ods]
2018-05-03 marcadores e .png osciloscopio
    [Arquivos Osciloscópio.ods]
2018-05-04 versao final (relatorio) :ok_hand:
    [conversor-boost - CADCAM Bottom Assembly.GBR, conversor-boost - CADCAM Bottom Copper.GBR, conversor-boost - CADCAM Bottom SMT Paste.GBR, conversor-boost - CADCAM Bottom Silk Screen.GBR, conversor-boost - CADCAM Bottom Solder Resist.GBR, conversor-boost - CADCAM Drill TOP-BOT Plated.GBR, conversor-boost - CADCAM Drill.DRL, conversor-boost - CADCAM Drill.GBR]
2018-05-05 Resistor 5R Gate NFET
